CalvinFetzek50/BSS_Microphone_System/Speaker/LTSpice Circuit/Speaker output.asc

AUDIO1: voltage; SINE(0 1 {freq/10})
C1: cap; 0.1µ
C2: cap; 1µ
C5: cap; 0.7µ
CARRIER1: voltage; PULSE(-3.3, 3.3, 0, {0.5/freq}, {0.5/freq}, 0, {1/freq})
L1: ind; 90µ
M1: nmos
M3: nmos
R1: res; 10
R2: res; 10
R5: res; 8
U1: LT1016
U2: LM5113_TRANS
V1: battery; 5
Named nets: 0, Carrier, Audio, PWM, PWM_INV, VCC, HS, Vout
.tran {100/freq}
.param freq=1k
PWM Generator
.include C:\\Users\\calvi\\Documents\\LTspice\\LTSpice_components\\lib\\sub\\LM5113.lib
