CalvinFetzek50/BSS_Microphone_System/Microphone/LTspice Circuit/Microphone input.asc

C2: cap; 23.3p
C3: cap; 64µ
C4: cap; 1.3µ
C5: cap; 6.4µ
MIC: voltage; SINE(0 0.1m 200); AC 0.1m
R1: res; 1k
R2: res; 170k
R3: res; 100k
R4: res; 50
R5: res; 100k
R6: res; 100k
U1: opa1656; OPA1656
V1: battery; 5
Named nets: 0, VCC, out
.include C:\\Users\\calvi\\AppData\\Local\\LTspice\\lib\\sub\\OPA1656.lib
.tran 50m
.include C:\\Users\\calvi\\AppData\\Local\\LTspice\\lib\\sub\\opa172.lib
.ac dec 100 1 100k
