CalvinFetzek50/BSS_Microphone_System/(commit log)

2025-02-08 Added ADC module and updated README
2025-02-16 added speaker circuit and edited documentation
